sebititita/TEI201_Grupo1Sec4-2026/hardware/fotos/v2_03_display.jpg

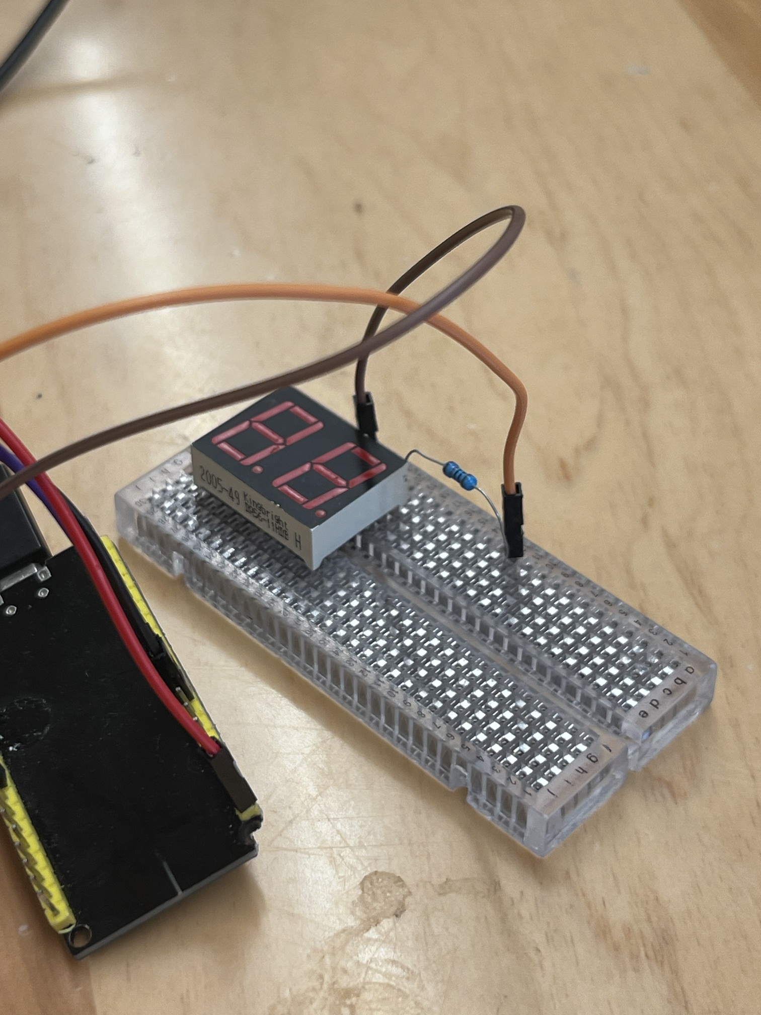
hardware/fotos/v2_03_display.jpg
