sebititita/TEI201_Grupo1Sec4-2026/hardware/fotos/v2_02_protoboard_divisor_echo.jpg

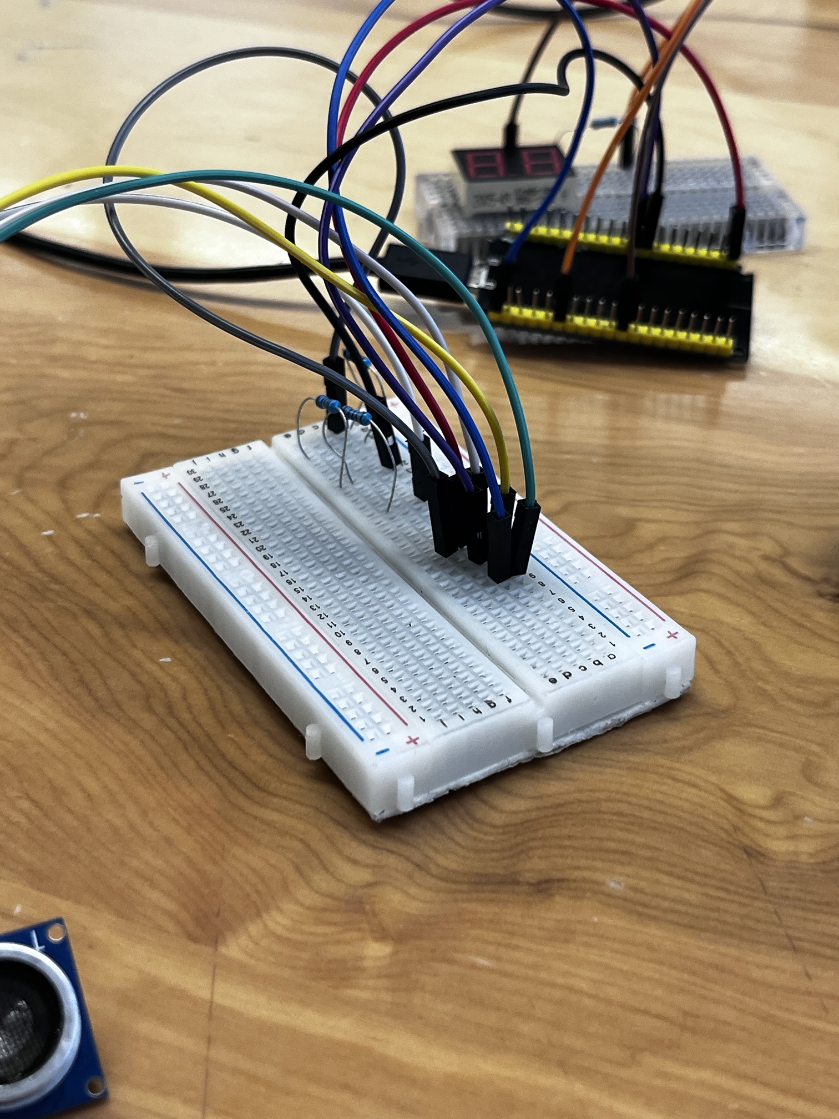
hardware/fotos/v2_02_protoboard_divisor_echo.jpg
