sebititita/TEI201_Grupo1Sec4-2026/diseno_3d/renders/README.md

# Renders

| Archivo | Vista |
|---|---|
| `01_vista_general_v2.png` | Isométrica frontal con el encapsulado cerrado |
| `02_interior_sin_tapa_v2.png` | Interior sin tapa (vista desde atrás): ESP32, protoboard, sensores y display |
| `03_corte_lateral_v2.png` | Corte por el sensor de P1 con cotas: altura del sensor (12 mm) y separación al auto (≈ 4 cm) |
