sebititita/TEI201_Grupo1Sec4-2026/hardware/fotos/README.md

# Fotografías del Prototipo (v2)

| Archivo | Contenido |
|---|---|
| `v2_01_vista_general.jpg` | Prototipo completo: HC-SR04, protoboards, ESP32, display y power bank |
| `v2_02_protoboard_divisor_echo.jpg` | Protoboard principal con las resistencias del divisor de voltaje |
| `v2_03_display.jpg` | Display de 7 segmentos en el protoboard transparente |
| `v2_04_sensor_hcsr04.jpg` | Sensor ultrasónico HC-SR04 con sus conexiones |
