sebititita/TEI201_Grupo1Sec4-2026/diseno_3d/renders/01_vista_general_v2.png

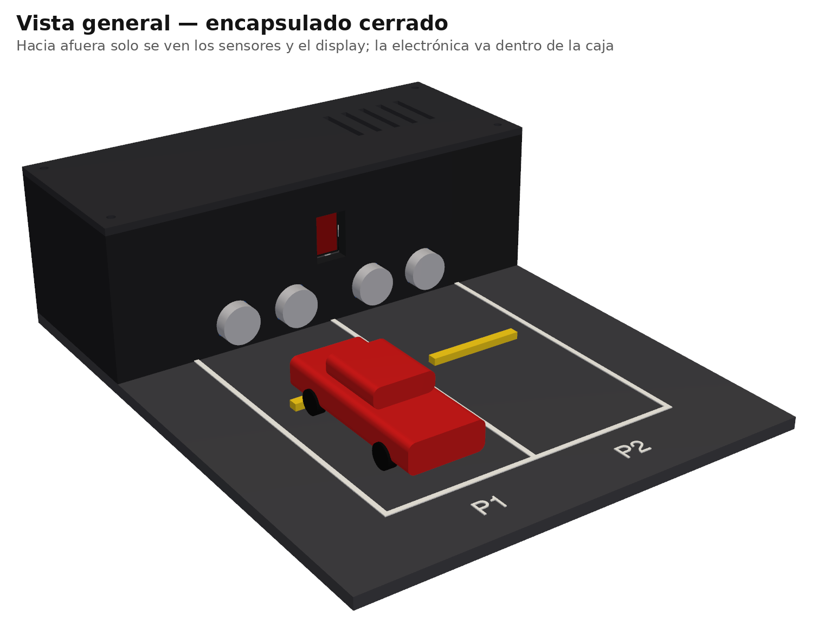
diseno_3d/renders/01_vista_general_v2.png
