sebititita/TEI201_Grupo1Sec4-2026/diseno_3d/renders/02_interior_sin_tapa_v2.png

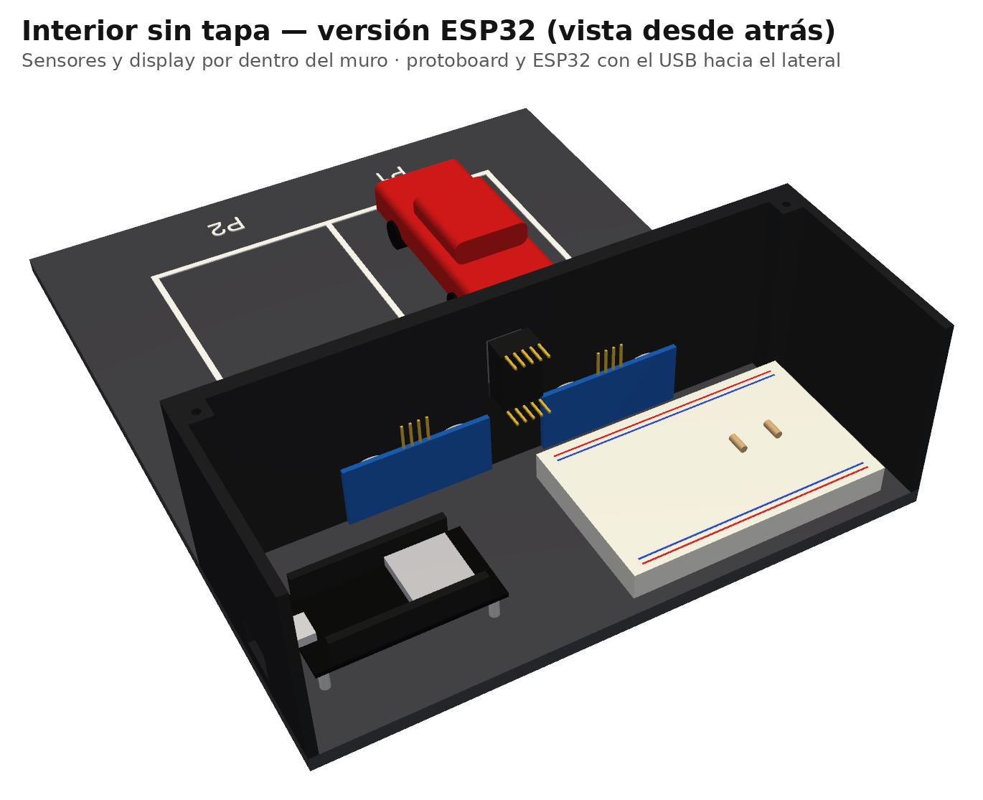
diseno_3d/renders/02_interior_sin_tapa_v2.png
