sebititita/TEI201_Grupo1Sec4-2026/diseno_3d/renders/03_corte_lateral_v2.png

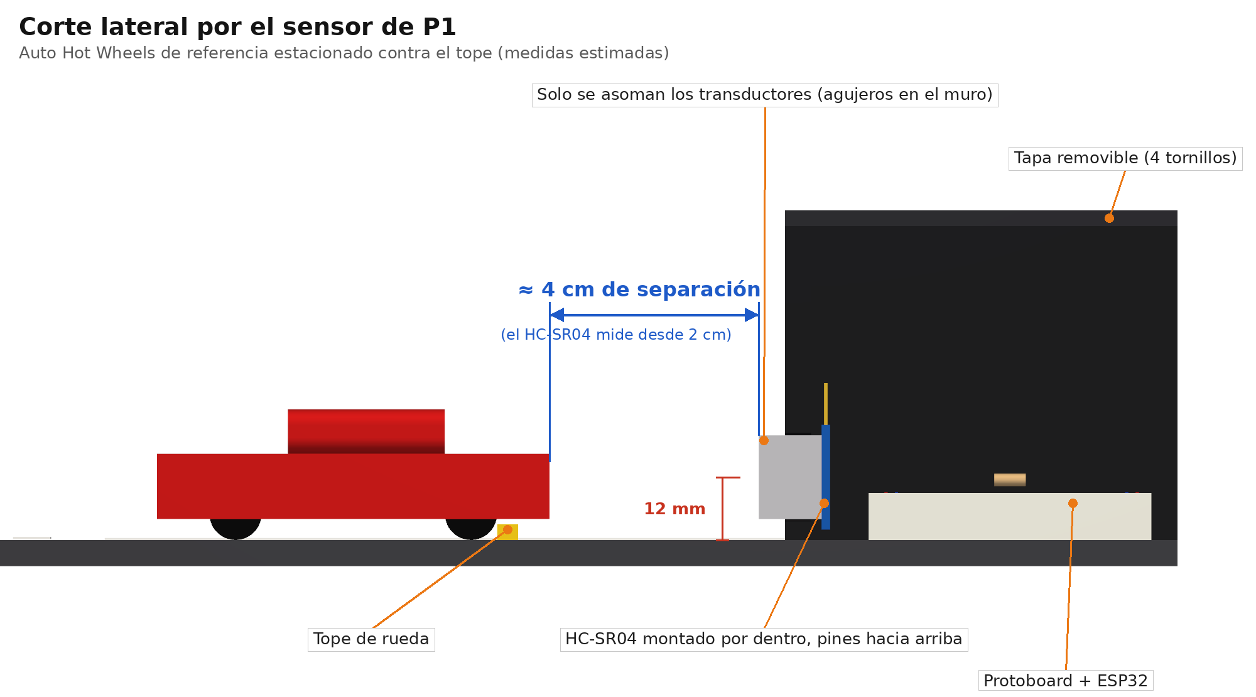
diseno_3d/renders/03_corte_lateral_v2.png
