sebititita/TEI201_Grupo1Sec4-2026/hardware/esquemas/v2_diagrama_conexiones_esp32.png

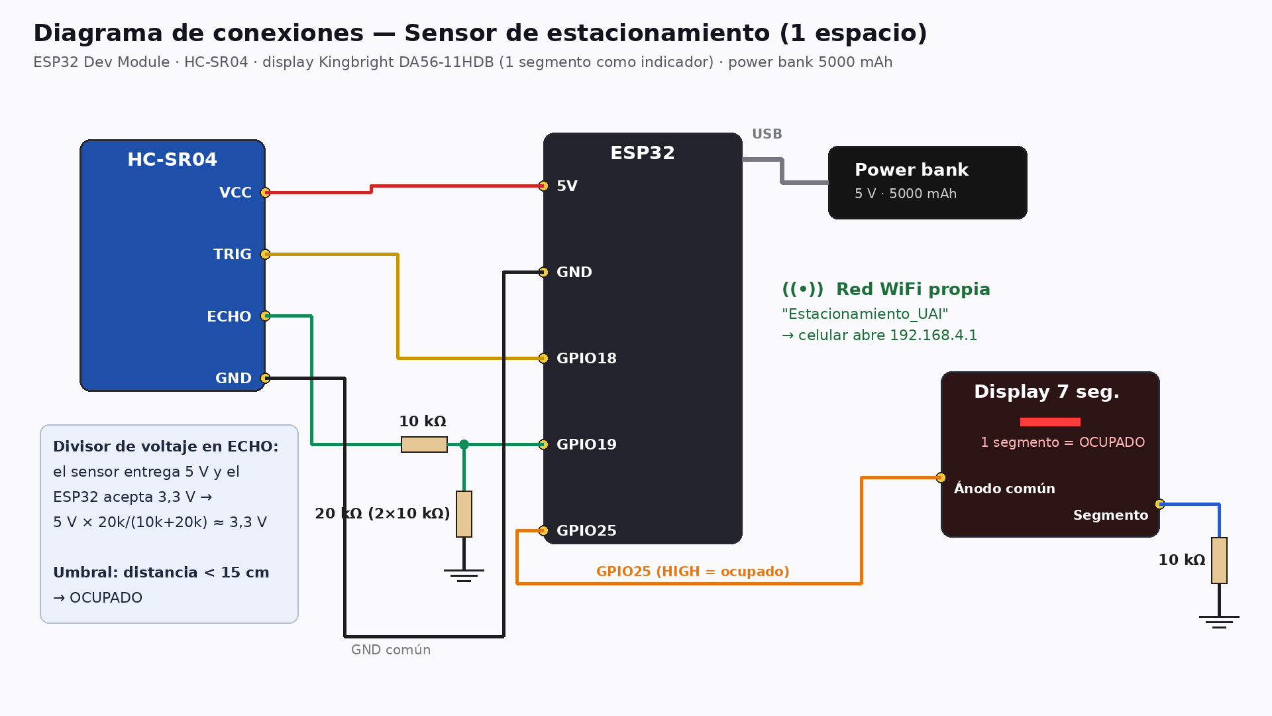
hardware/esquemas/v2_diagrama_conexiones_esp32.png
