sebititita/TEI201_Grupo1Sec4-2026/hardware/fotos/v2_01_vista_general.jpg

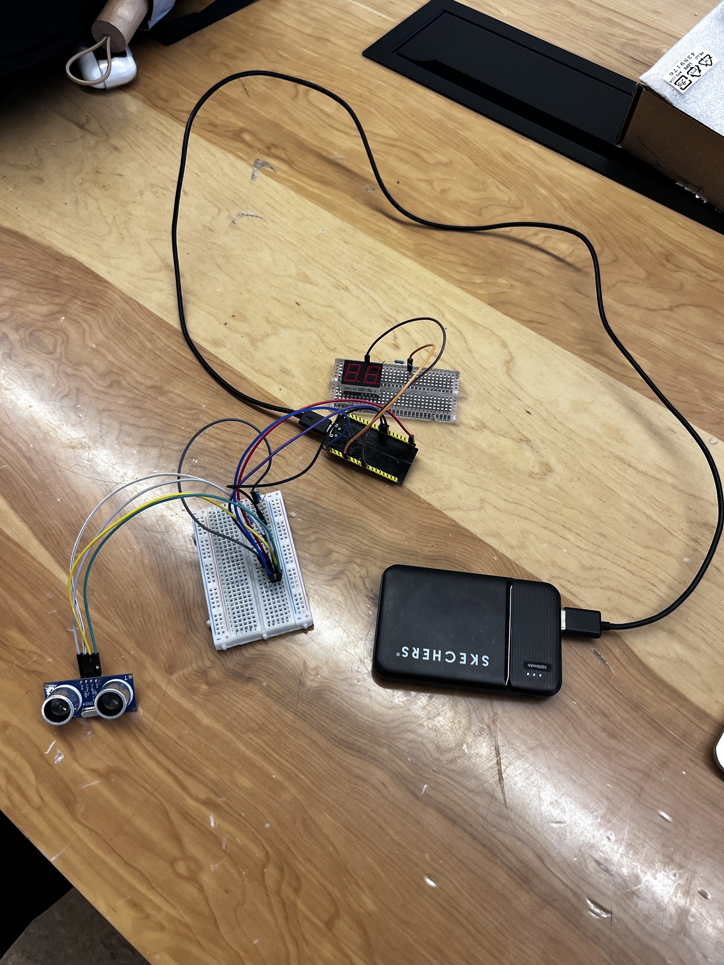
hardware/fotos/v2_01_vista_general.jpg
