sebititita/TEI201_Grupo1Sec4-2026/hardware/fotos/v2_04_sensor_hcsr04.jpg

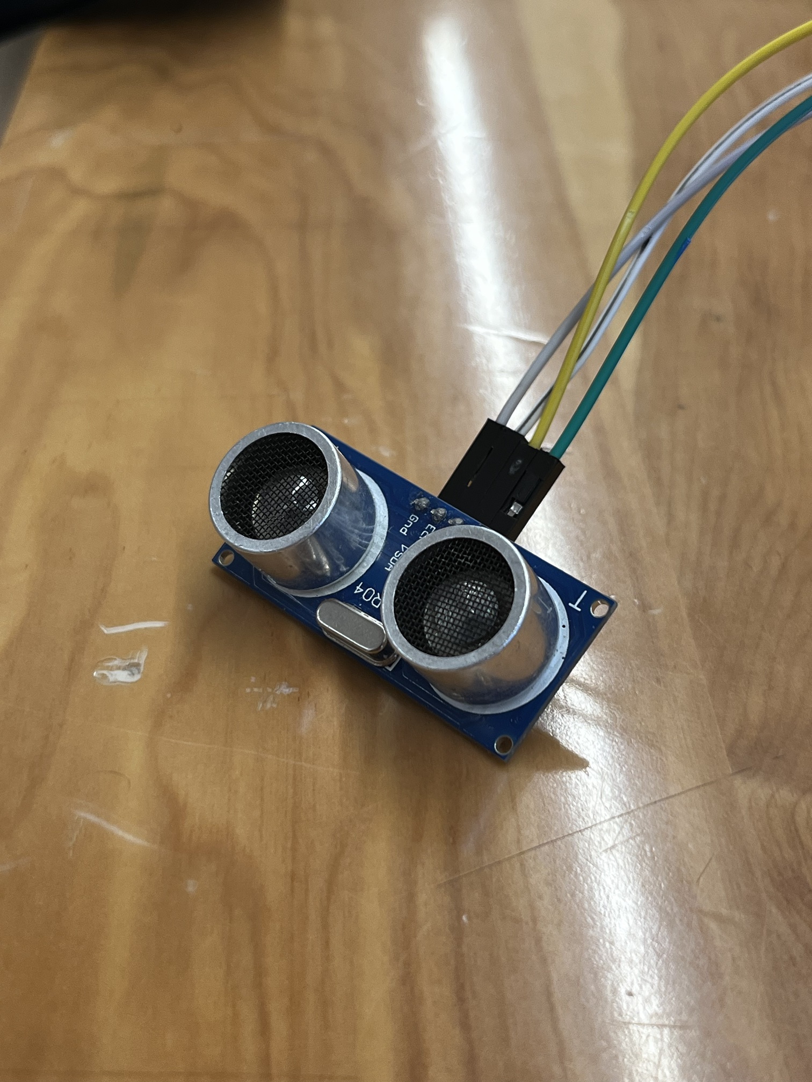
hardware/fotos/v2_04_sensor_hcsr04.jpg
