sebititita/TEI201_Grupo1Sec4-2026/iteraciones/comparativa_v1_v2_diseno3d.png

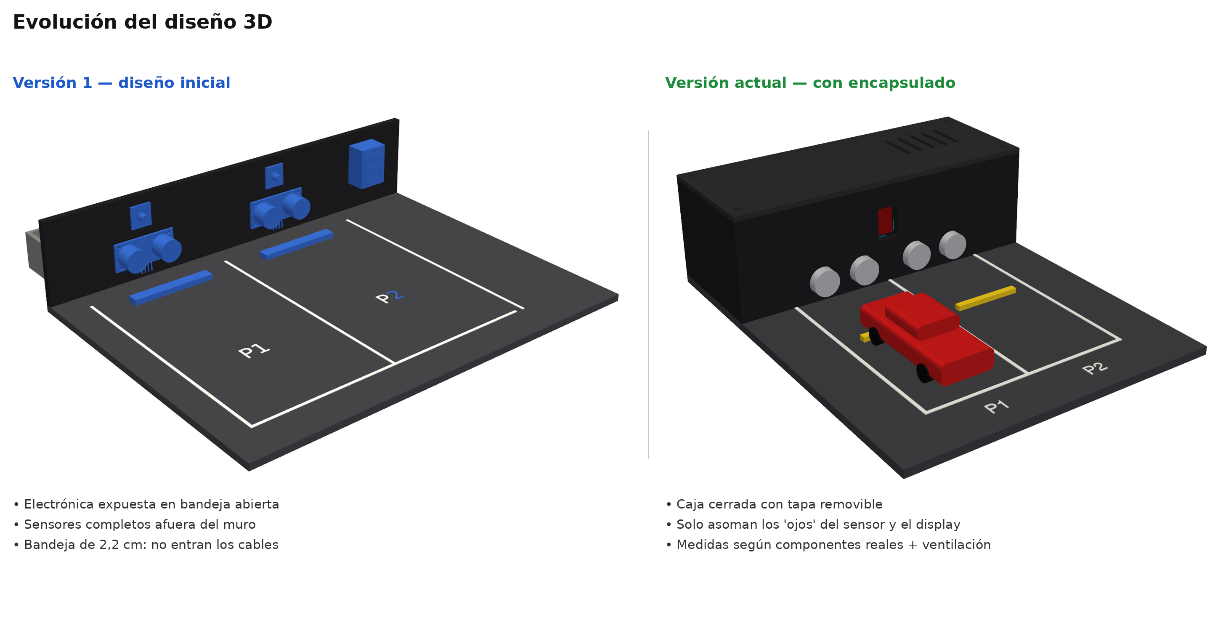
iteraciones/comparativa_v1_v2_diseno3d.png
