sebititita/TEI201_Grupo1Sec4-2026/iteraciones/iteracion_1/v1_referencia_conceptual.jpg

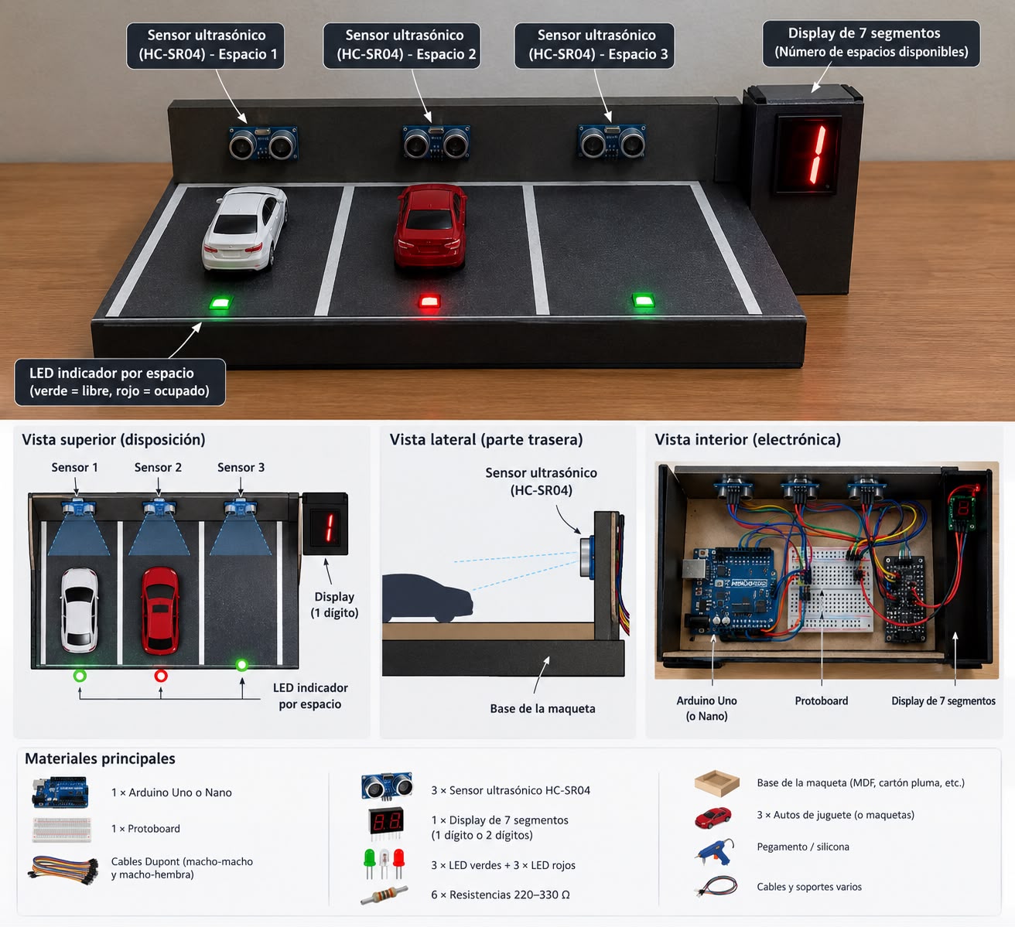
iteraciones/iteracion_1/v1_referencia_conceptual.jpg
