sebititita/TEI201_Grupo1Sec4-2026/iteraciones/iteracion_1/v1_render_modelo_inicial.png

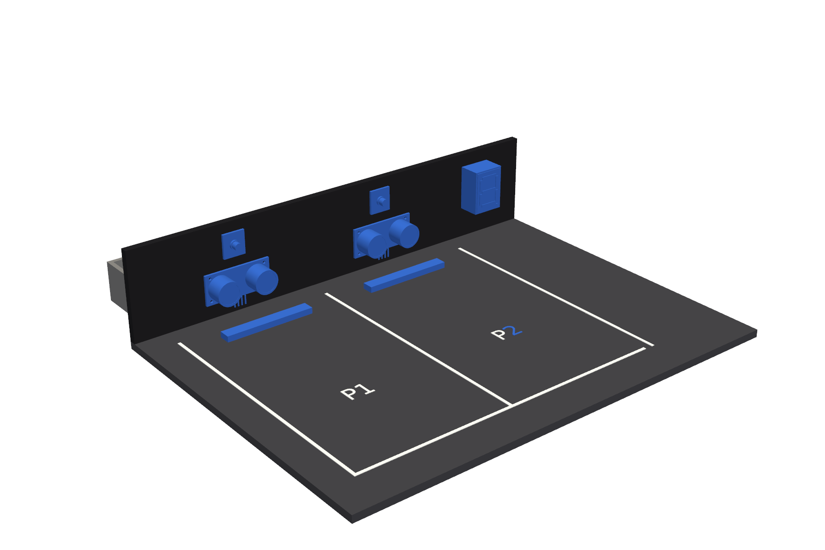
iteraciones/iteracion_1/v1_render_modelo_inicial.png
