sebititita/TEI201_Grupo1Sec4-2026/software/docs/imagenes_codigo/codigo_esp32_1de3.png

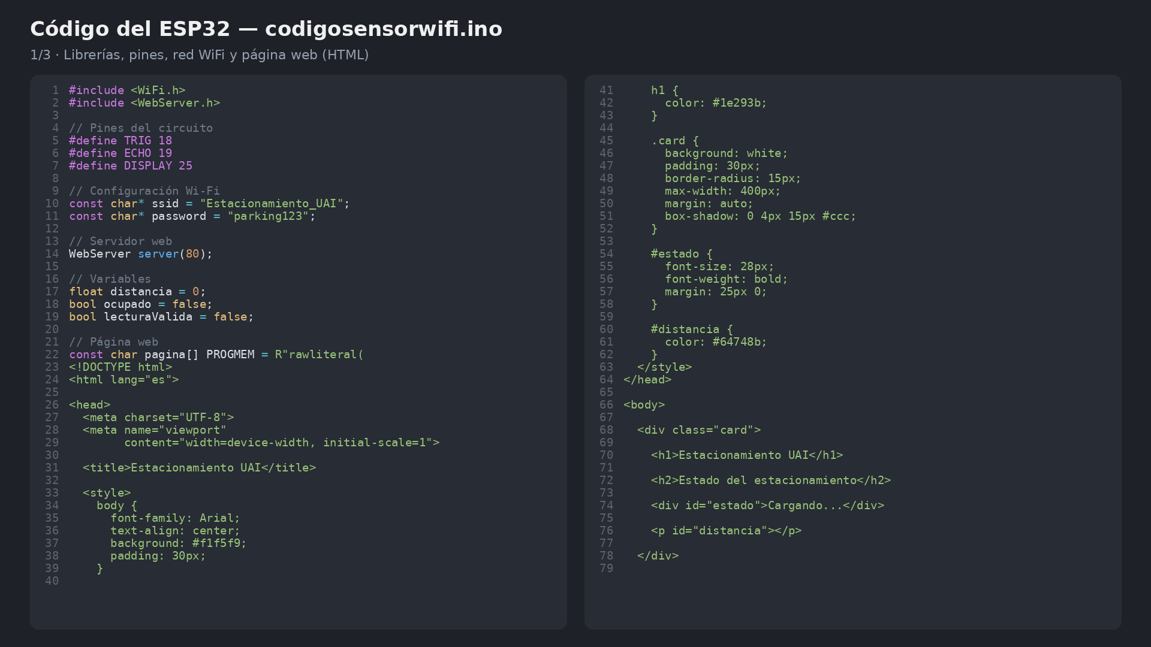
software/docs/imagenes_codigo/codigo_esp32_1de3.png
