sebititita/TEI201_Grupo1Sec4-2026/hardware/bom/README.md

# Bill of Materials (BOM) — Prototipo v2

| Cantidad | Componente | Especificación | Uso en el proyecto | Datasheet |
|---|---|---|---|---|
| 1 | ESP32 Dev Module | 38 pines, WiFi + Bluetooth | Microcontrolador y servidor web | [Espressif ESP32](https://www.espressif.com/en/products/socs/esp32) |
| 1 | Sensor ultrasónico HC-SR04 | 5 V, rango 2–400 cm | Detectar el vehículo | [HC-SR04 (AllDatasheet)](https://www.alldatasheet.com/view.jsp?Searchword=HC-SR04) |
| 1 | Display 7 segmentos Kingbright DA56-11HDB | 2 dígitos, ánodo común | Indicador de ocupado (1 segmento) | [Kingbright](https://www.kingbrightusa.com) |
| 4 | Resistencias 10 kΩ | 1/4 W | 3 para el divisor de ECHO, 1 para el segmento | — |
| 1 | Protoboard blanca | — | Circuito principal | — |
| 1 | Protoboard transparente pequeña | — | Display | — |
| — | Cables Dupont macho-macho y macho-hembra | — | Conexiones | — |
| 1 | Cable USB | Compatible con el ESP32 | Programación y alimentación | — |
| 1 | Power bank | 5 V, 5000 mAh | Alimentación portátil | — |

**Componentes adquiridos pero no integrados en v2:** 1 sensor HC-SR04 adicional (para el segundo espacio) y módulo LED RGB.

## Presupuesto
Precios por completar con las boletas o los links de compra del equipo.
