sebititita/TEI201_Grupo1Sec4-2026/diseno_3d/fusion360/modelo_v2_ESP32.step

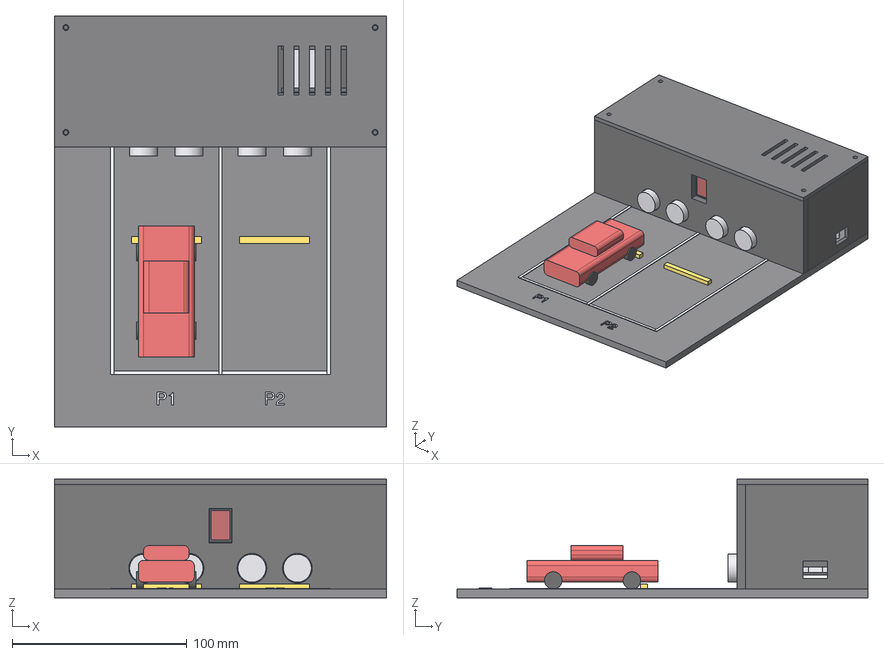
[picture p13: CAD file, 2026-10-26]
diseno_3d/fusion360/modelo_v2_ESP32.step
190.0 x 235.0 x 68.0 mm
01_Base
Linea_division_1
Linea_division_2
Linea_division_3
Linea_frontal_P1
Tope_rueda_P1
Identificacion_P1
Linea_frontal_P2
Tope_rueda_P2
Identificacion_P2
02_Encapsulado_muro_frontal
03_Encapsulado_lateral_izq
04_Encapsulado_lateral_der_con_pasacable_USB
05_Encapsulado_trasera_con_ventilacion
Poste_tapa_1
Poste_tapa_2
Poste_tapa_3
Poste_tapa_4
06_Tapa_removible_atornillada
HC_SR04_P1_placa
HC_SR04_P1_emisor
HC_SR04_P1_receptor
HC_SR04_P1_pines_hacia_arriba
HC_SR04_P2_placa
HC_SR04_P2_emisor
HC_SR04_P2_receptor
HC_SR04_P2_pines_hacia_arriba
Display_7seg_cuerpo
Display_7seg_frente
Display_7seg_pines
Protoboard_400
Protoboard_riel_1
Protoboard_riel_2
Protoboard_riel_3
Protoboard_riel_4
Resistencia_1
Resistencia_2
Separador_ESP32_128_194
Separador_ESP32_177_194
Separador_ESP32_128_216
Separador_ESP32_177_216
ESP32_placa
ESP32_modulo_wifi
ESP32_conector_USB
ESP32_headers
Auto_referencia_HotWheels
Auto_referencia_ruedas
