sebititita/TEI201_Grupo1Sec4-2026/iteraciones/iteracion_1/v1_modelo3d_inicial.step

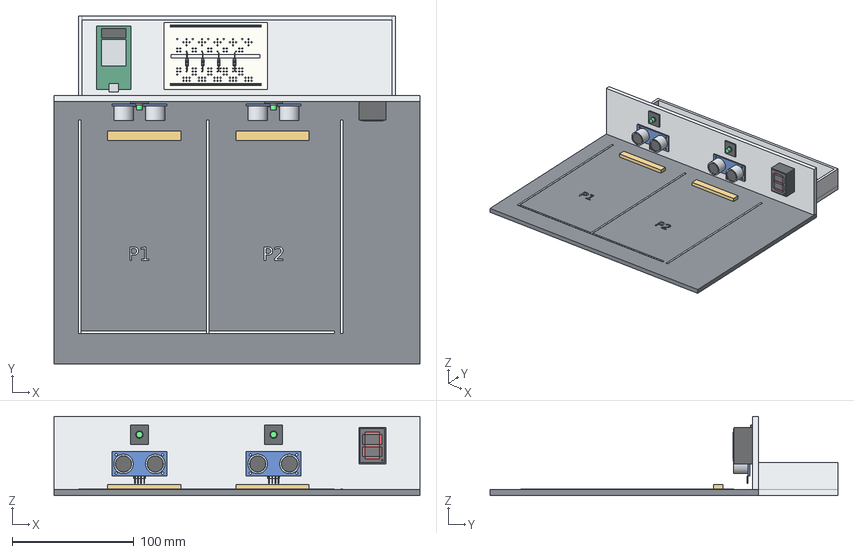
[picture p14: CAD file, 2026-10-26]
iteraciones/iteracion_1/v1_modelo3d_inicial.step
300.0 x 285.0 x 65.0 mm
01_Base_300x220x5_mm
02_Muro_trasero_con_pasacables
03_Bandeja_electronica_abierta
Linea_plaza_1
Linea_plaza_2
Linea_plaza_3
Linea_frontal_1
Tope_rueda_1
Linea_frontal_2
Tope_rueda_2
Identificacion_P1
HC_SR04_1_placa_aproximada
HC_SR04_1_transductor_1
HC_SR04_1_malla_1
HC_SR04_1_transductor_2
HC_SR04_1_malla_2
HC_SR04_1_pines
LED_RGB_1_modulo_KY016_aproximado
LED_RGB_1_base
LED_RGB_1_lente
Identificacion_P2
HC_SR04_2_placa_aproximada
HC_SR04_2_transductor_1
HC_SR04_2_malla_1
HC_SR04_2_transductor_2
HC_SR04_2_malla_2
HC_SR04_2_pines
LED_RGB_2_modulo_KY016_aproximado
LED_RGB_2_base
LED_RGB_2_lente
Display_7_segmentos_carcasa_aproximada
Display_7_segmentos_frente
Display_segmento_1
Display_segmento_2
Display_segmento_3
Display_segmento_4
Display_segmento_5
Display_segmento_6
Display_segmento_7
Display_punto_decimal
ESP32_DevKit_placa_28x52_aproximada
ESP32_modulo_metalico
ESP32_antena
ESP32_conector_USB
ESP32_header_0
ESP32_pines_0
ESP32_header_1
ESP32_pines_1
Protoboard_85x55_aproximada
Protoboard_riel_rojo_0
Protoboard_riel_azul_0
Protoboard_riel_rojo_1
Protoboard_riel_azul_1
Resistencia_1_cuerpo
Resistencia_1_terminales
Resistencia_1_banda_0
Resistencia_1_banda_1
Resistencia_1_banda_2
Resistencia_2_cuerpo
Resistencia_2_terminales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
