sebititita/TEI201_Grupo1Sec4-2026/testing/evidencias/fotos/v2_pagina_web_LIBRE.png

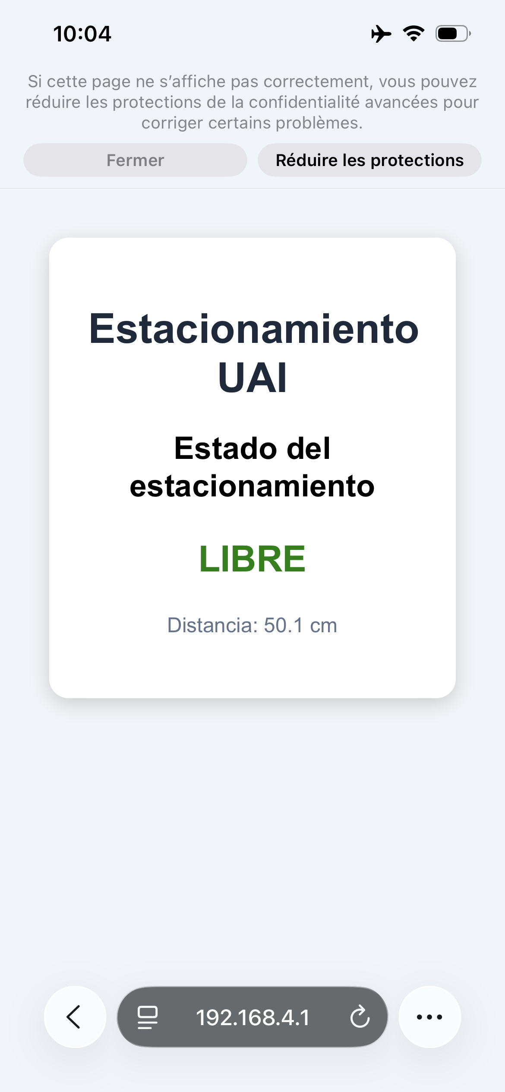
testing/evidencias/fotos/v2_pagina_web_LIBRE.png
